Groger63/ChaiseBureau_TO52/architecture.jpg

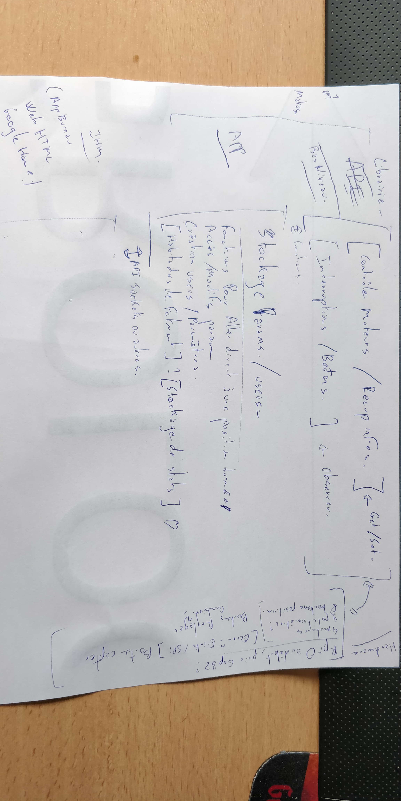
architecture.jpg
