Groger63/ChaiseBureau_TO52/Photos/Existant/IHM_box (2).jpg

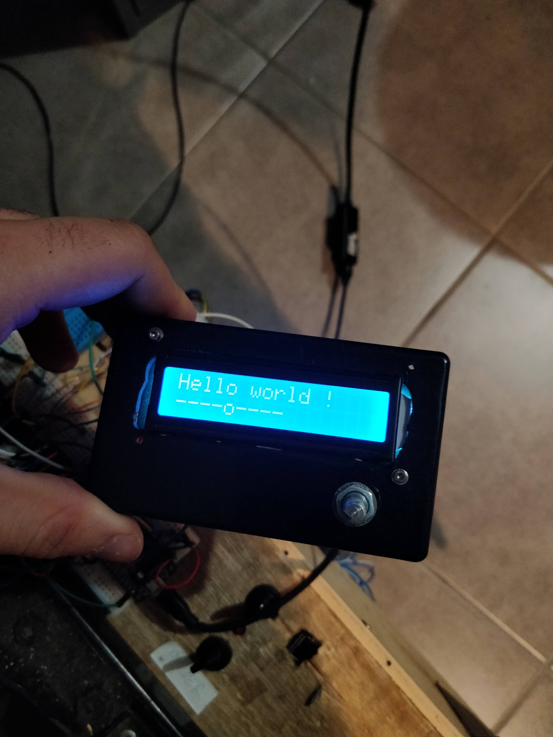
Photos/Existant/IHM_box (2).jpg
