Groger63/ChaiseBureau_TO52/Code/schéma menus.png

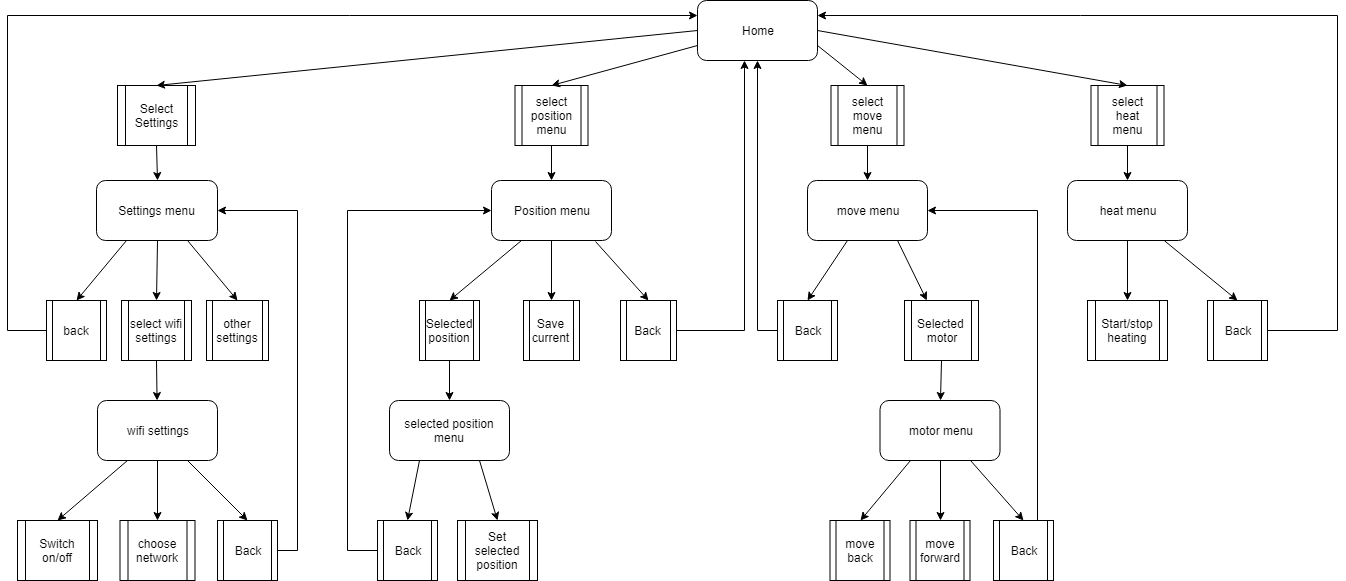
Code/schéma menus.png
