Groger63/ChaiseBureau_TO52/Photos/Existant/2018-10-23 18.43.49.jpg

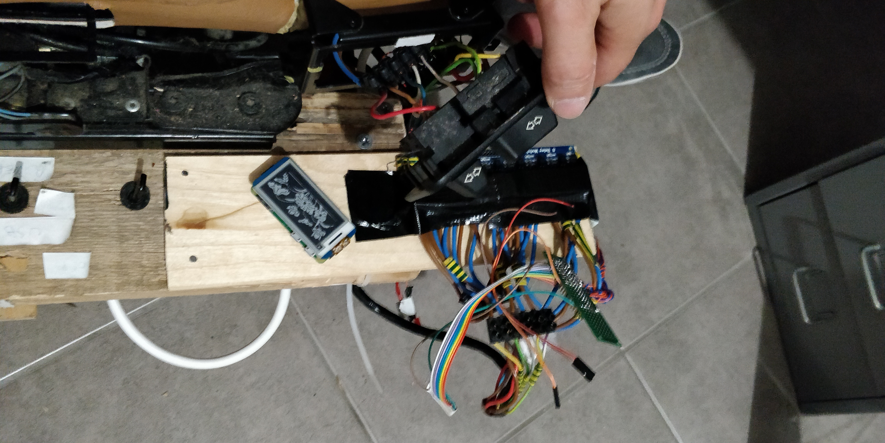
Photos/Existant/2018-10-23 18.43.49.jpg
