Groger63/ChaiseBureau_TO52/Photos/Existant/2018-10-24 00.53.45.jpg

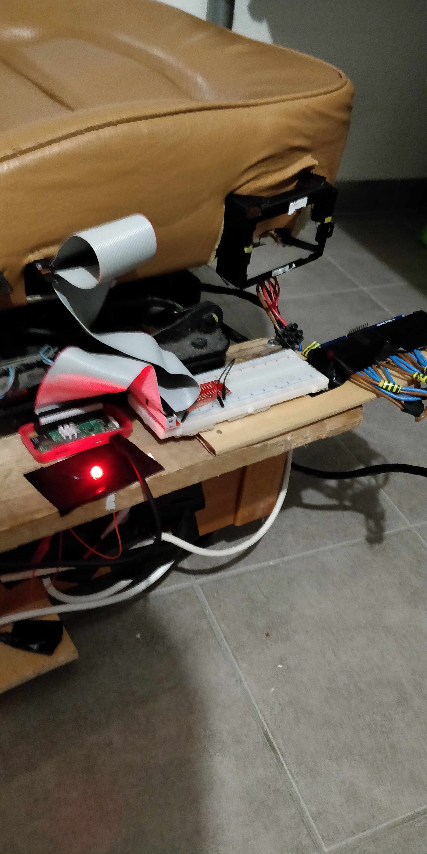
Photos/Existant/2018-10-24 00.53.45.jpg
