Groger63/ChaiseBureau_TO52/Photos/Existant/2018-10-24 11.01.03.jpg

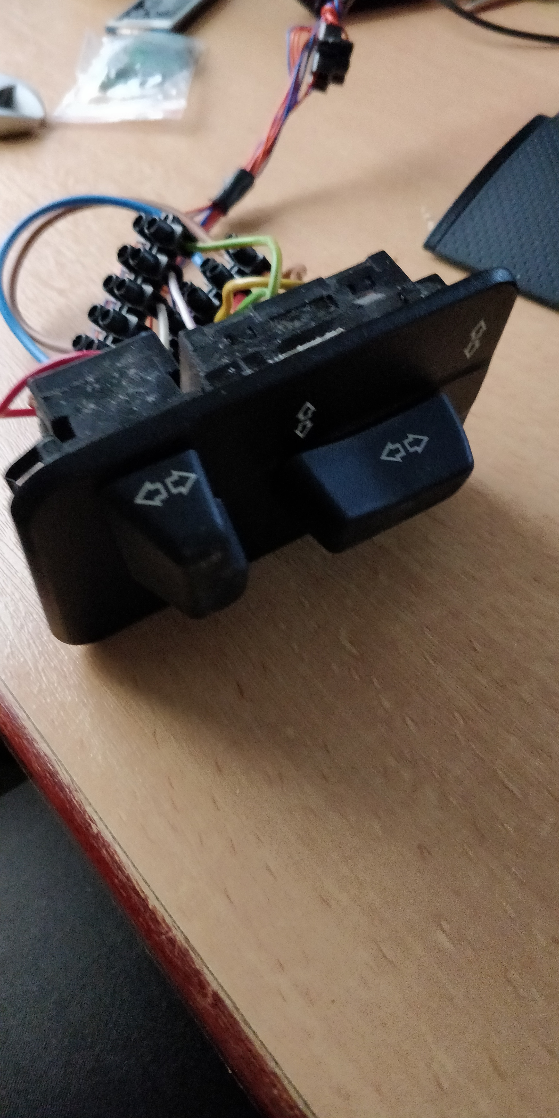
Photos/Existant/2018-10-24 11.01.03.jpg
