Groger63/ChaiseBureau_TO52/Photos/Existant/Arduini_mega.jpg

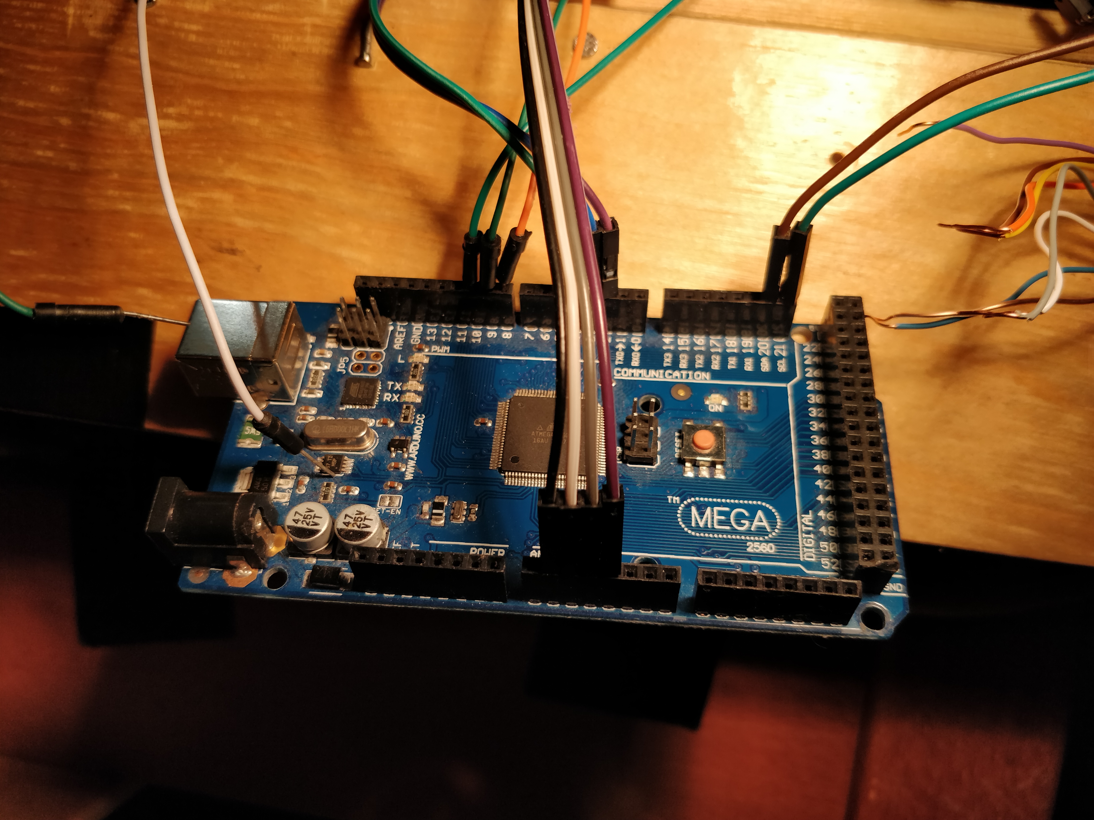
Photos/Existant/Arduini_mega.jpg
