Groger63/ChaiseBureau_TO52/Photos/Existant/Arduino_mega (2).jpg

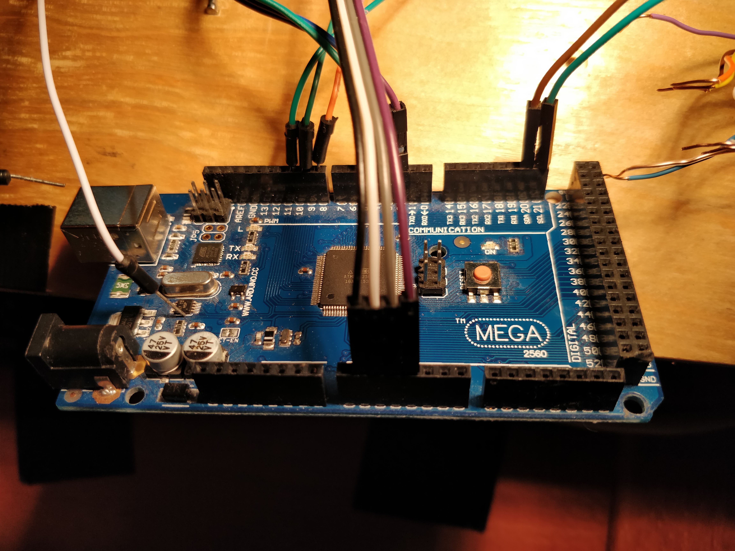
Photos/Existant/Arduino_mega (2).jpg
