Groger63/ChaiseBureau_TO52/Photos/Existant/dossier_adaptator.jpg

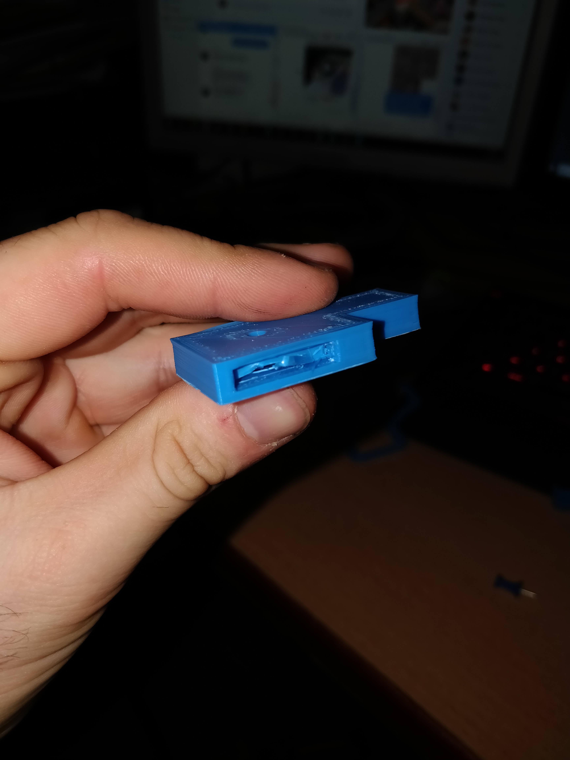
Photos/Existant/dossier_adaptator.jpg
