Groger63/ChaiseBureau_TO52/Photos/Existant/IHM_box.jpg

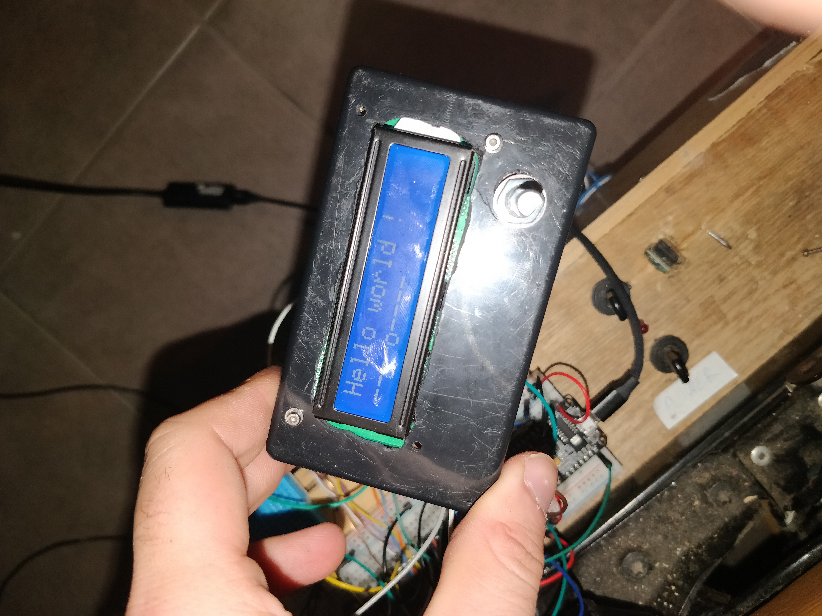
Photos/Existant/IHM_box.jpg
