Groger63/ChaiseBureau_TO52/Photos/Existant/mounted_dossier_adaptator.jpg

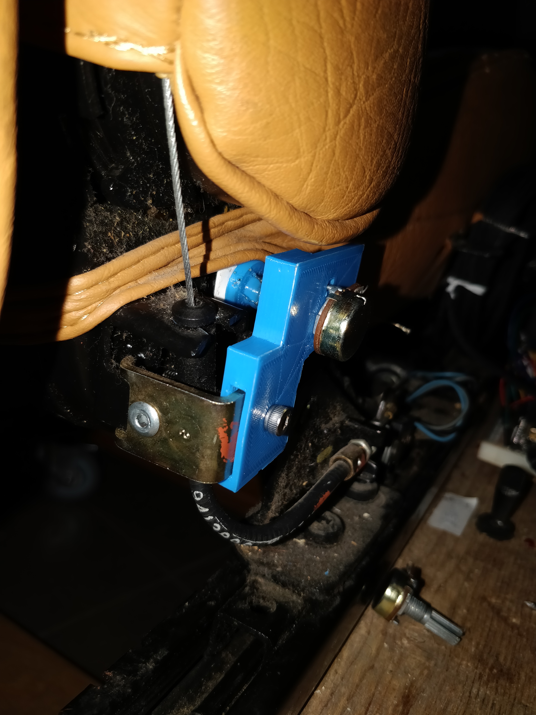
Photos/Existant/mounted_dossier_adaptator.jpg
