Groger63/ChaiseBureau_TO52/Photos/Existant/Ride The Lighning.jpg

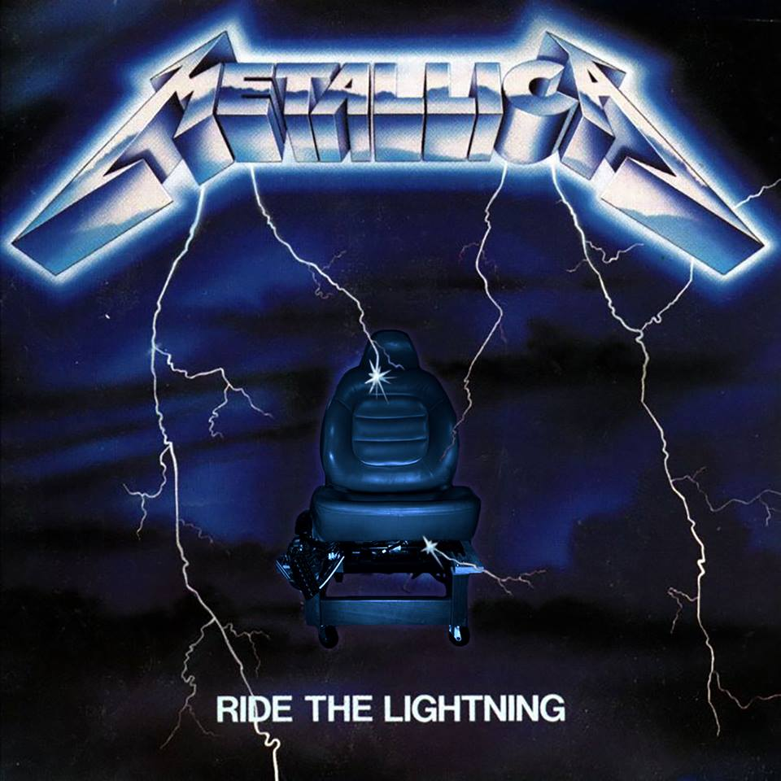
Photos/Existant/Ride The Lighning.jpg
