Groger63/ChaiseBureau_TO52/Photos/Existant/Screen.jpg

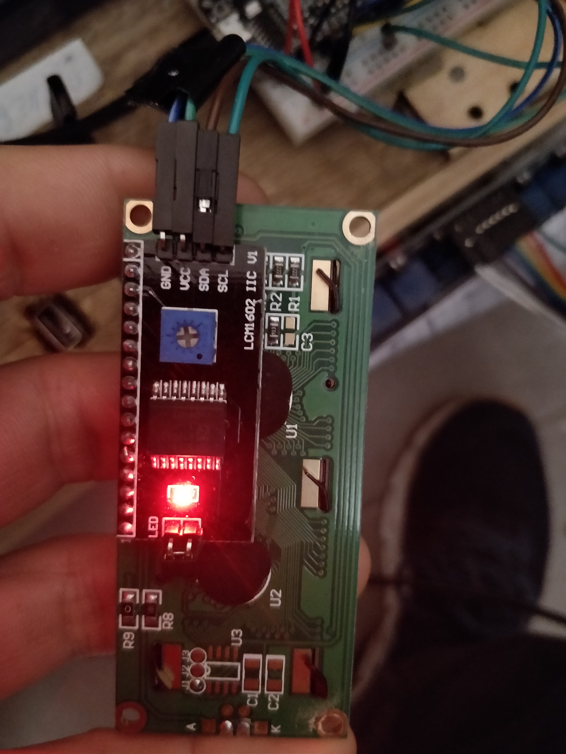
Photos/Existant/Screen.jpg
