Groger63/ChaiseBureau_TO52/Photos/Existant/Seat_front (2).jpg

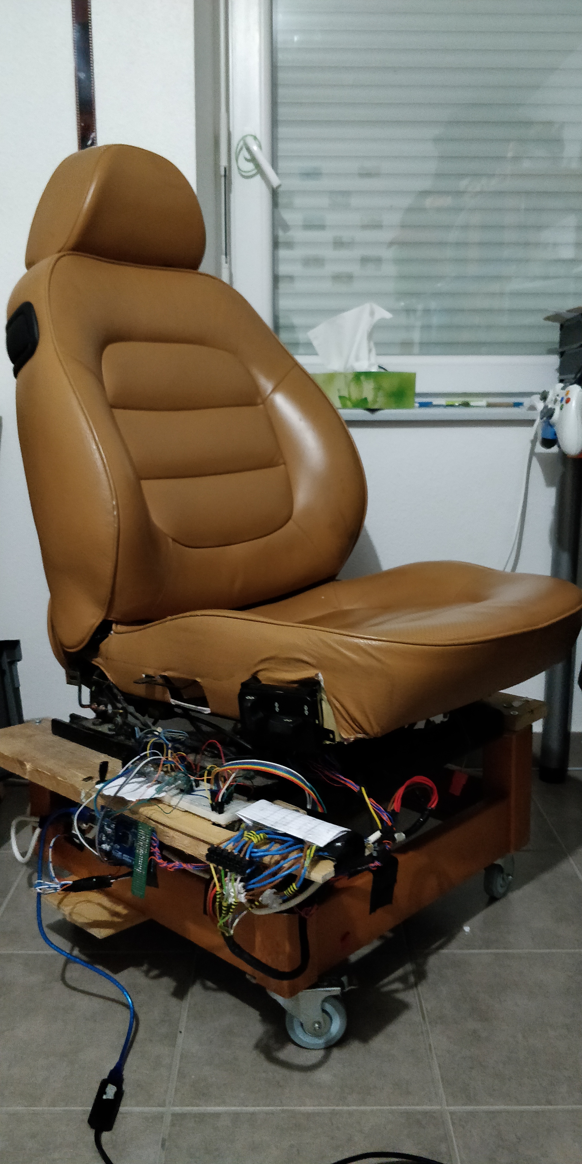
Photos/Existant/Seat_front (2).jpg
