Groger63/ChaiseBureau_TO52/Photos/Existant/Seat_front.jpg

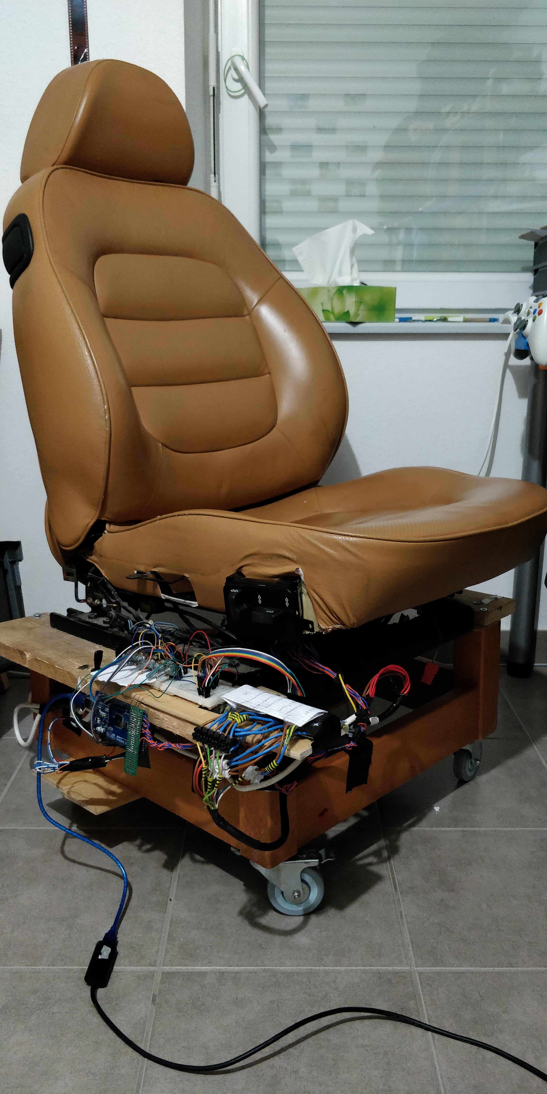
Photos/Existant/Seat_front.jpg
