Groger63/ChaiseBureau_TO52/Photos/Existant/Seat_right.jpg

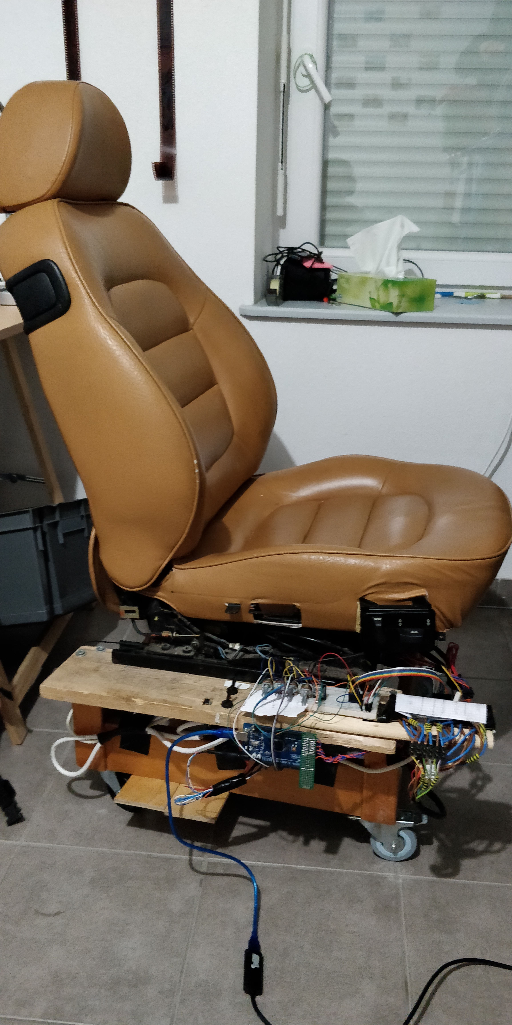
Photos/Existant/Seat_right.jpg
