Groger63/ChaiseBureau_TO52/Photos/Schémas/0001.jpg

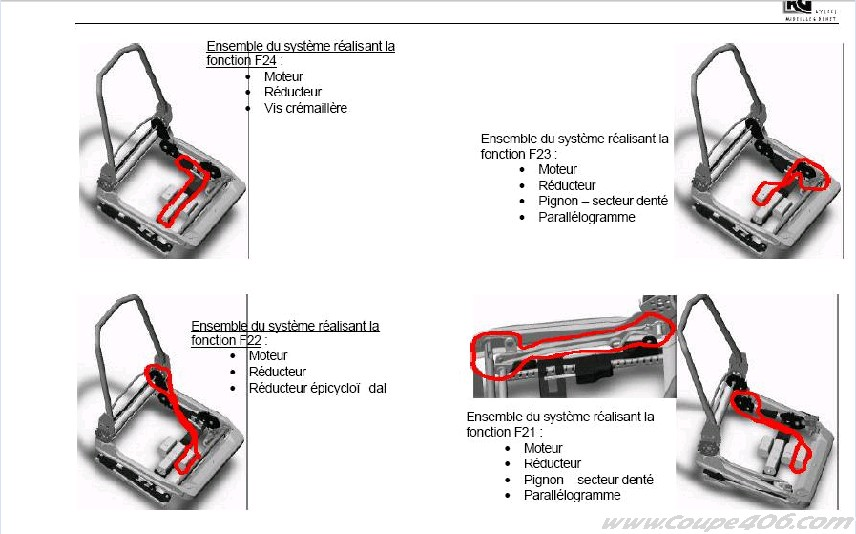
Photos/Schémas/0001.jpg
