Groger63/ChaiseBureau_TO52/Hardware/Nomenclature Boutons.txt

Dossier AV/AR : blanc + bleu
Assive haut/bas : vert&jaune + blanc&violet
Assise AV/AR : vert + gris
Genoux haut/bas : jaune + noir
