Groger63/ChaiseBureau_TO52/Hardware/pièces mécaniques/Assise/potentiometre_assise_1.stl

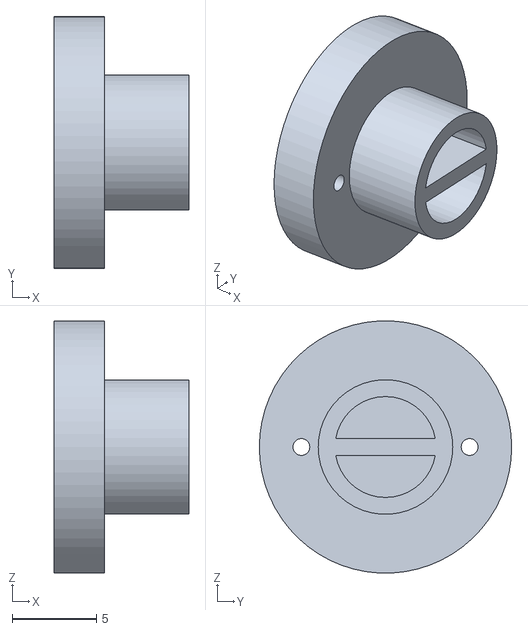
[picture p39: CAD file, 2018-12-28]
Hardware/pièces mécaniques/Assise/potentiometre_assise_1.stl
8.00 x 15.0 x 15.0
