Groger63/ChaiseBureau_TO52/Hardware/pièces mécaniques/Avancement/cremaillere.stl

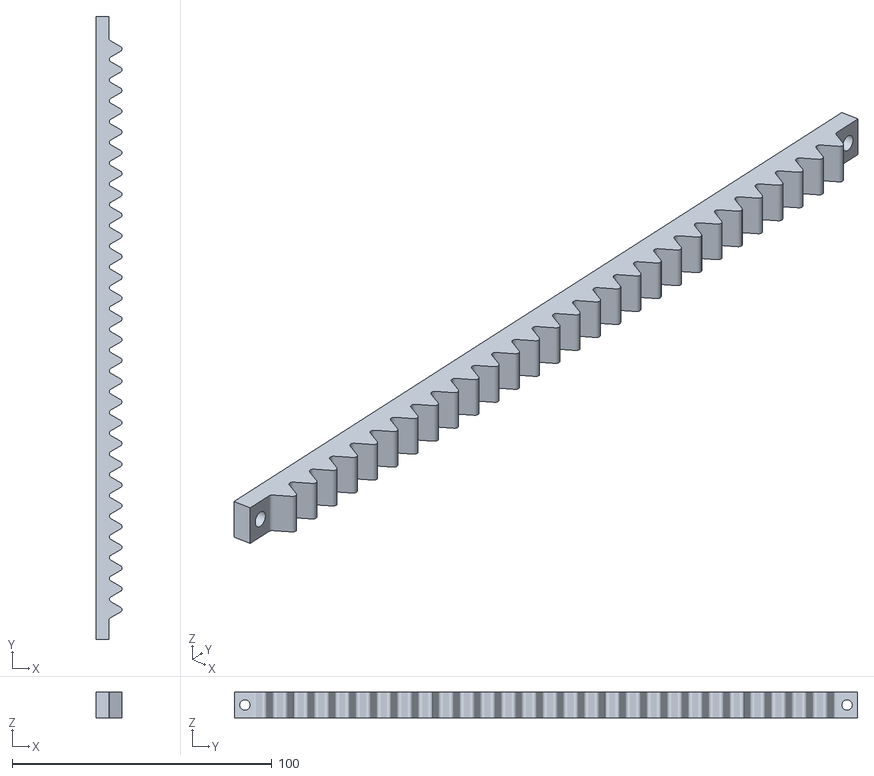
[picture p40: CAD file, 2018-12-28]
Hardware/pièces mécaniques/Avancement/cremaillere.stl
10.1 x 240.0 x 10.0
