Groger63/ChaiseBureau_TO52/Hardware/pièces mécaniques/Hauteur/SupportPotardV2.stl

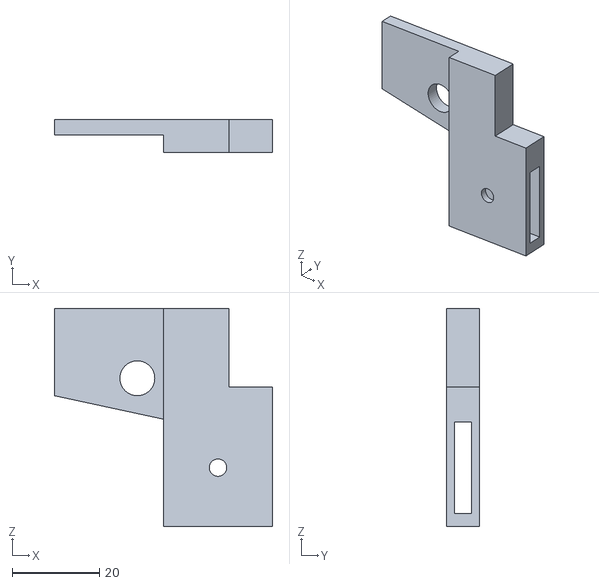
[picture p41: CAD file, 2018-12-28]
Hardware/pièces mécaniques/Hauteur/SupportPotardV2.stl
50.0 x 7.50 x 50.0
