Groger63/ChaiseBureau_TO52/Hardware/pièces mécaniques/Avancement/adaptateur_pot_assise2.stl

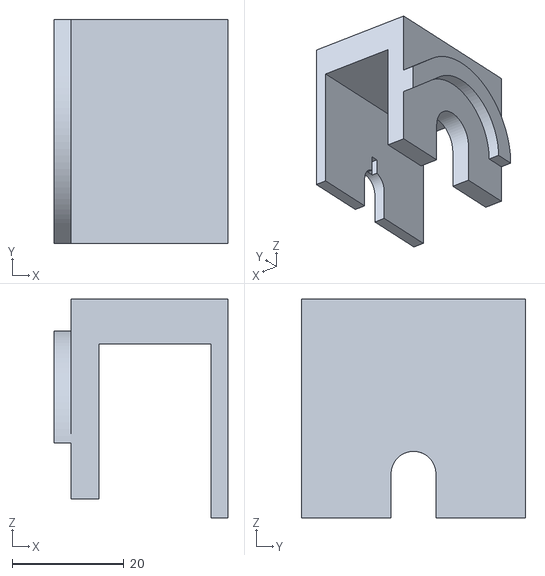
[picture p42: CAD file, 2018-12-28]
Hardware/pièces mécaniques/Avancement/adaptateur_pot_assise2.stl
31.0 x 40.0 x 39.1
