Groger63/ChaiseBureau_TO52/Hardware/pièces mécaniques/Hauteur/potentiometre_assise_1.stl

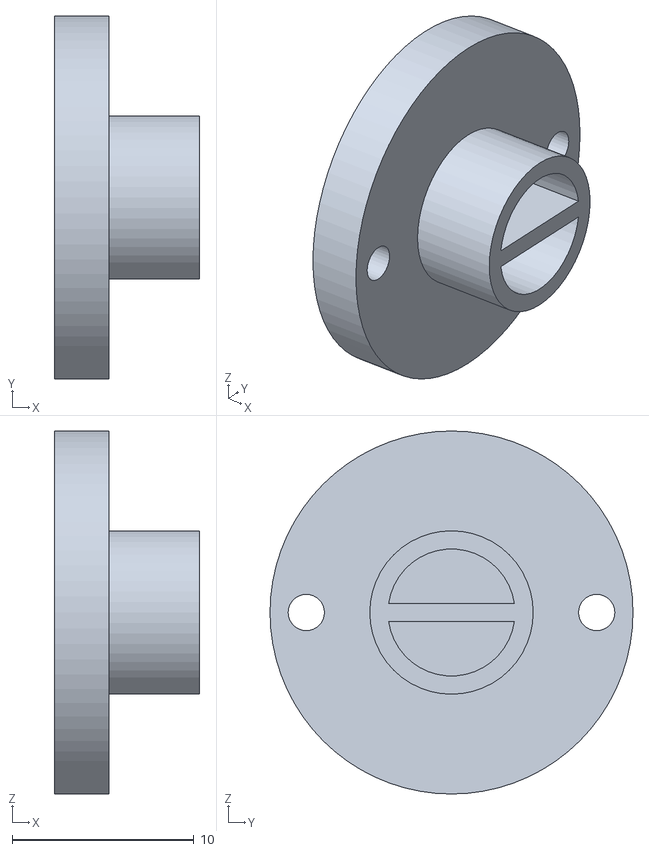
[picture p43: CAD file, 2018-12-28]
Hardware/pièces mécaniques/Hauteur/potentiometre_assise_1.stl
8.00 x 20.0 x 20.0
