Groger63/ChaiseBureau_TO52/Hardware/pièces mécaniques/Avancement/roue.stl

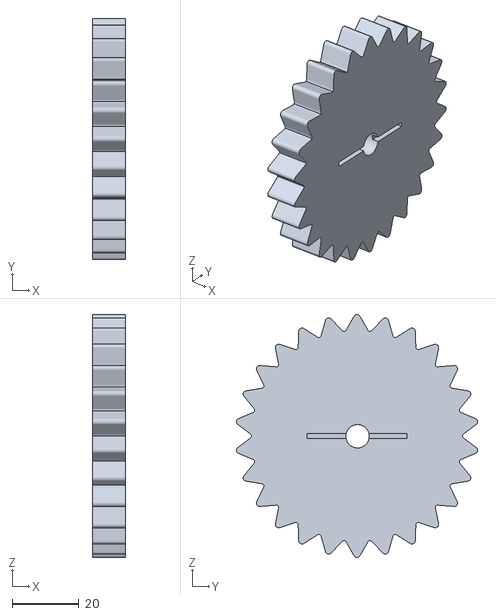
[picture p44: CAD file, 2018-12-28]
Hardware/pièces mécaniques/Avancement/roue.stl
10.0 x 72.2 x 72.7
