Groger63/ChaiseBureau_TO52/Hardware/pièces mécaniques/Hauteur/SupportPotard2.stl

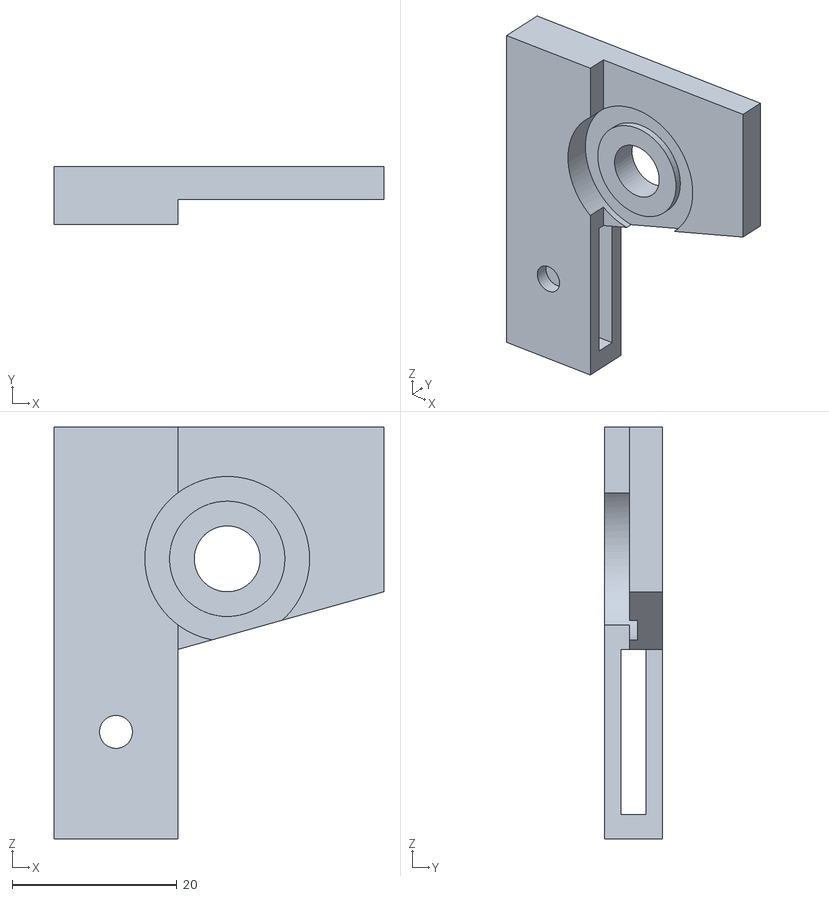
[picture p45: CAD file, 2018-12-28]
Hardware/pièces mécaniques/Hauteur/SupportPotard2.stl
40.0 x 7.00 x 50.0
