Groger63/ChaiseBureau_TO52/(list of files, cad)

Other CAD files:
Hardware/pièces mécaniques/Assise/RoueAssise.CATPart
Hardware/pièces mécaniques/Assise/RoueAssise2.CATPart
Hardware/pièces mécaniques/Avancement/adaptateur_pot_assise2.CATPart
Hardware/pièces mécaniques/Avancement/assemblage avancement.CATProduct
Hardware/pièces mécaniques/Avancement/cremaillere.CATPart
Hardware/pièces mécaniques/Avancement/cremaillere2.CATPart
Hardware/pièces mécaniques/Avancement/potentiometre_assise_1.CATPart
Hardware/pièces mécaniques/Avancement/roue.CATPart
Hardware/pièces mécaniques/Hauteur/Part1.CATPart
Hardware/pièces mécaniques/Hauteur/Product1.CATProduct
Hardware/pièces mécaniques/Hauteur/Produit1.CATProduct
Hardware/pièces mécaniques/Hauteur/SupportPotard.CATPart
Hardware/pièces mécaniques/Hauteur/SupportPotard2.CATPart
Hardware/pièces mécaniques/Hauteur/SupportPotardV2.0.CATPart
Hardware/pièces mécaniques/Hauteur/potentiometre_assise_1.CATPart
Hardware/pièces mécaniques/Hauteur/potentiometre_assise_3.CATPart
Hardware/pièces mécaniques/Product1.CATProduct
Hardware/pièces mécaniques/RouesArnaud/cremaillaire pignon angle helice.CATPart
Hardware/pièces mécaniques/RouesArnaud/pignon angle helice.CATPart
Hardware/pièces mécaniques/User Library-Potentiometer-3.CATPART
Hardware/pièces mécaniques/adaptateur_pot_assise.CATPart
Hardware/pièces mécaniques/assise.CATProduct
Hardware/pièces mécaniques/avancement.CATProduct
Hardware/pièces mécaniques/potentiometre_assise_1.CATPart
