Groger63/ChaiseBureau_TO52/Hardware/PCB design/TO52/Schematics_backup2.brd

## EAGLE design Hardware/PCB design/TO52/Schematics_backup2.brd (2019-01-02)

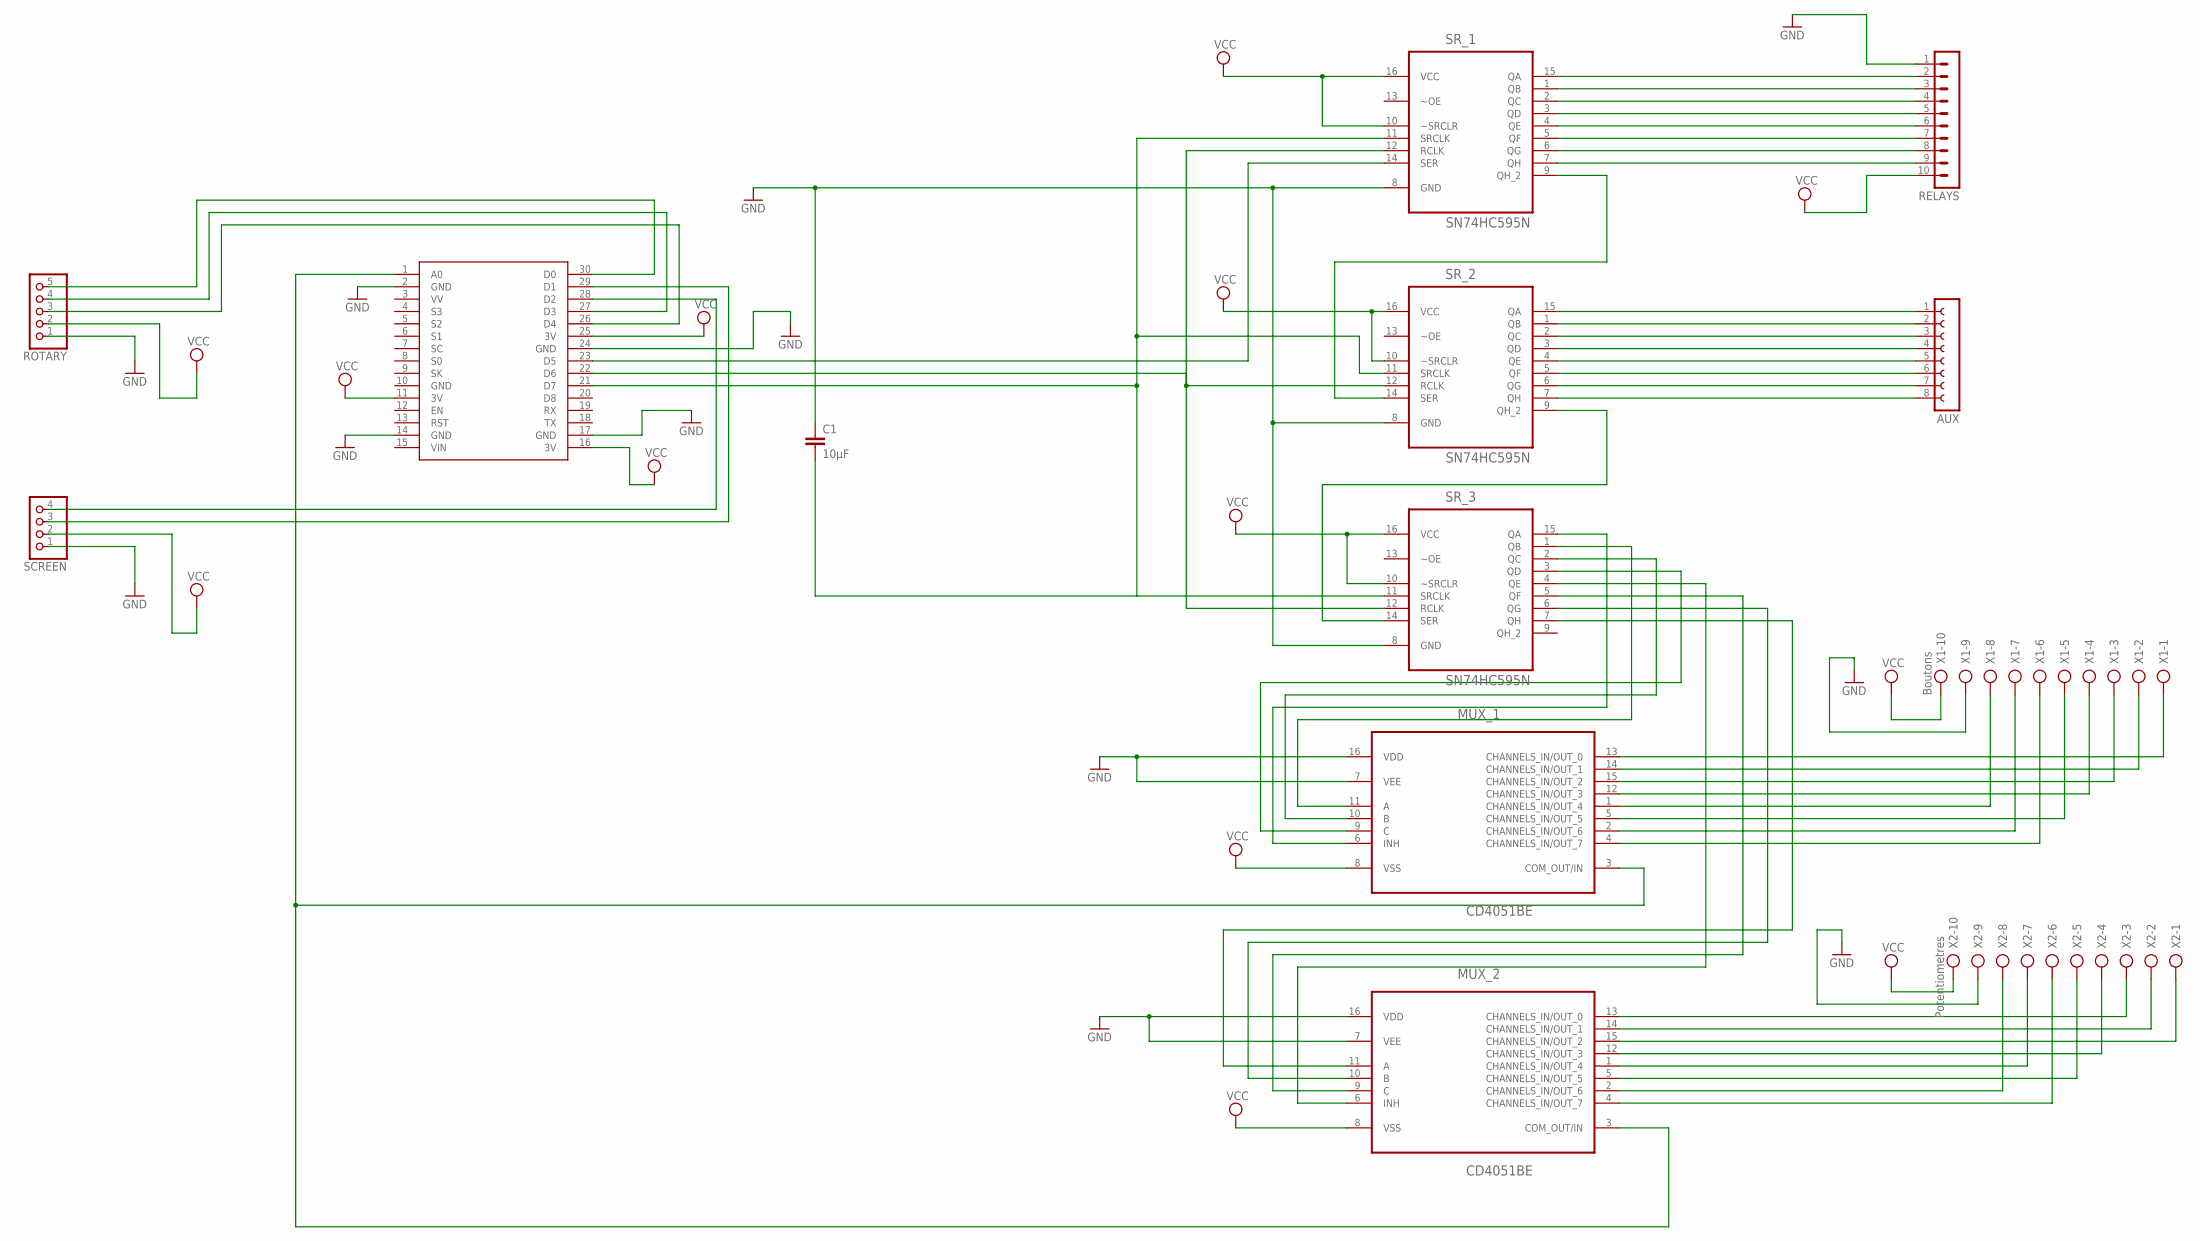
[picture p46: schematic Schematics_backup2.sch]

Parts:
AUX: FE08-1; FE08
C1: 10µF; C2.5-3
MUX_1, MUX_2: CD4051BE; DIP254P762X508-16
RELAYS: MA10-1W
ROTARY: PINHD-1X5; 1X05
SCREEN: PINHD-1X4; 1X04
SR_1, SR_2, SR_3: SN74HC595N; DIP254P762X508-16
U$1: NODEMCU
X1: Boutons; AK300/10
X2: Potentiometres; AK300/10

Connections:
GND: C1.1, MUX_1.7 (VEE), MUX_1.16 (VDD), MUX_2.7 (VEE), MUX_2.16 (VDD), RELAYS.1, ROTARY.1, SCREEN.1, SR_1.8 (GND), SR_2.8 (GND), SR_3.8 (GND), U$1.2 (GND), U$1.10 (GND), U$1.14 (GND), U$1.17 (GND), U$1.24 (GND), X1.9, X2.9
unnamed: RELAYS.2, SR_1.15 (QA)
unnamed: SR_1.14 (SER), U$1.23 (D5)
unnamed: SR_1.12 (RCLK), SR_2.12 (RCLK), SR_3.12 (RCLK), U$1.22 (D6)
unnamed: SR_2.9 (QH_2), SR_3.14 (SER)
unnamed: C1.2, SR_1.11 (SRCLK), SR_2.11 (SRCLK), SR_3.11 (SRCLK), U$1.21 (D7)
unnamed: RELAYS.3, SR_1.1 (QB)
unnamed: RELAYS.4, SR_1.2 (QC)
unnamed: RELAYS.5, SR_1.3 (QD)
unnamed: RELAYS.6, SR_1.4 (QE)
unnamed: RELAYS.7, SR_1.5 (QF)
unnamed: RELAYS.8, SR_1.6 (QG)
unnamed: RELAYS.9, SR_1.7 (QH)
unnamed: MUX_1.13 (CHANNELS_IN/OUT_0), X1.1
unnamed: MUX_1.14 (CHANNELS_IN/OUT_1), X1.2
unnamed: SR_1.9 (QH_2), SR_2.14 (SER)
unnamed: MUX_1.15 (CHANNELS_IN/OUT_2), X1.3
unnamed: MUX_1.12 (CHANNELS_IN/OUT_3), X1.4
unnamed: MUX_1.1 (CHANNELS_IN/OUT_4), X1.8
unnamed: MUX_1.5 (CHANNELS_IN/OUT_5), X1.5
unnamed: MUX_1.2 (CHANNELS_IN/OUT_6), X1.7
unnamed: MUX_1.4 (CHANNELS_IN/OUT_7), X1.6
unnamed: MUX_2.1 (CHANNELS_IN/OUT_4), X2.7
unnamed: MUX_2.2 (CHANNELS_IN/OUT_6), X2.8
unnamed: MUX_1.6 (INH), SR_3.15 (QA)
unnamed: MUX_1.11 (A), SR_3.1 (QB)
unnamed: MUX_1.10 (B), SR_3.2 (QC)
unnamed: MUX_1.9 (C), SR_3.3 (QD)
unnamed: MUX_2.6 (INH), SR_3.4 (QE)
unnamed: MUX_2.9 (C), SR_3.5 (QF)
unnamed: MUX_2.10 (B), SR_3.6 (QG)
unnamed: MUX_2.11 (A), SR_3.7 (QH)
unnamed: MUX_1.3 (COM_OUT/IN), MUX_2.3 (COM_OUT/IN), U$1.1 (A0)
unnamed: MUX_2.4 (CHANNELS_IN/OUT_7), X2.6
unnamed: MUX_2.5 (CHANNELS_IN/OUT_5), X2.5
unnamed: MUX_2.12 (CHANNELS_IN/OUT_3), X2.4
unnamed: MUX_2.15 (CHANNELS_IN/OUT_2), X2.1
unnamed: MUX_2.14 (CHANNELS_IN/OUT_1), X2.2
unnamed: MUX_2.13 (CHANNELS_IN/OUT_0), X2.3
unnamed: AUX.1, SR_2.15 (QA)
unnamed: AUX.2, SR_2.1 (QB)
unnamed: AUX.3, SR_2.2 (QC)
unnamed: AUX.4, SR_2.3 (QD)
unnamed: AUX.5, SR_2.4 (QE)
unnamed: AUX.6, SR_2.5 (QF)
unnamed: AUX.7, SR_2.6 (QG)
unnamed: AUX.8, SR_2.7 (QH)
unnamed: ROTARY.3, U$1.26 (D4)
unnamed: ROTARY.5, U$1.30 (D0)
unnamed: ROTARY.4, U$1.27 (D3)
unnamed: SCREEN.4, U$1.28 (D2)
unnamed: SCREEN.3, U$1.29 (D1)
VCC: MUX_1.8 (VSS), MUX_2.8 (VSS), RELAYS.10, ROTARY.2, SCREEN.2, SR_1.10 (~SRCLR), SR_1.16 (VCC), SR_2.10 (~SRCLR), SR_2.16 (VCC), SR_3.10 (~SRCLR), SR_3.16 (VCC), U$1.11 (3V), U$1.16 (3V), U$1.25 (3V), X1.10, X2.10

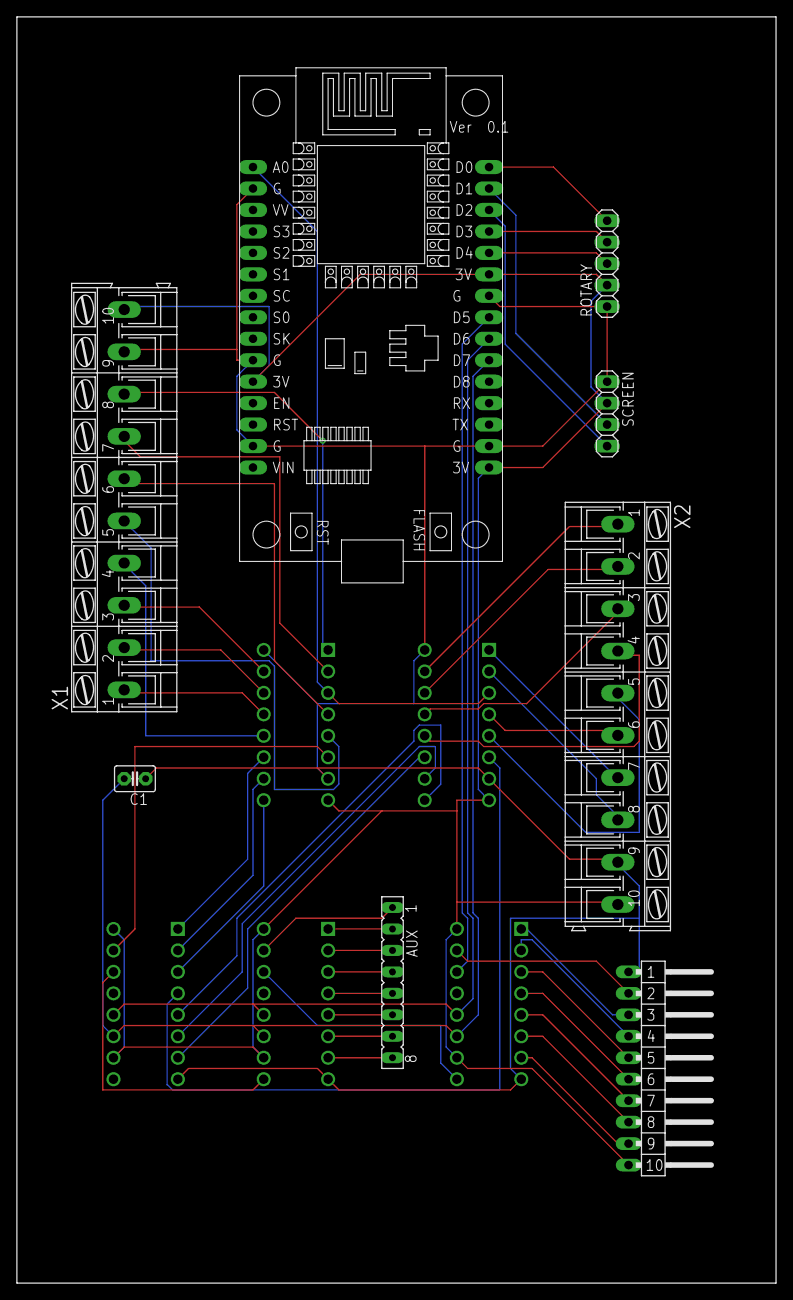
[picture p47: board Schematics_backup2.brd from above]

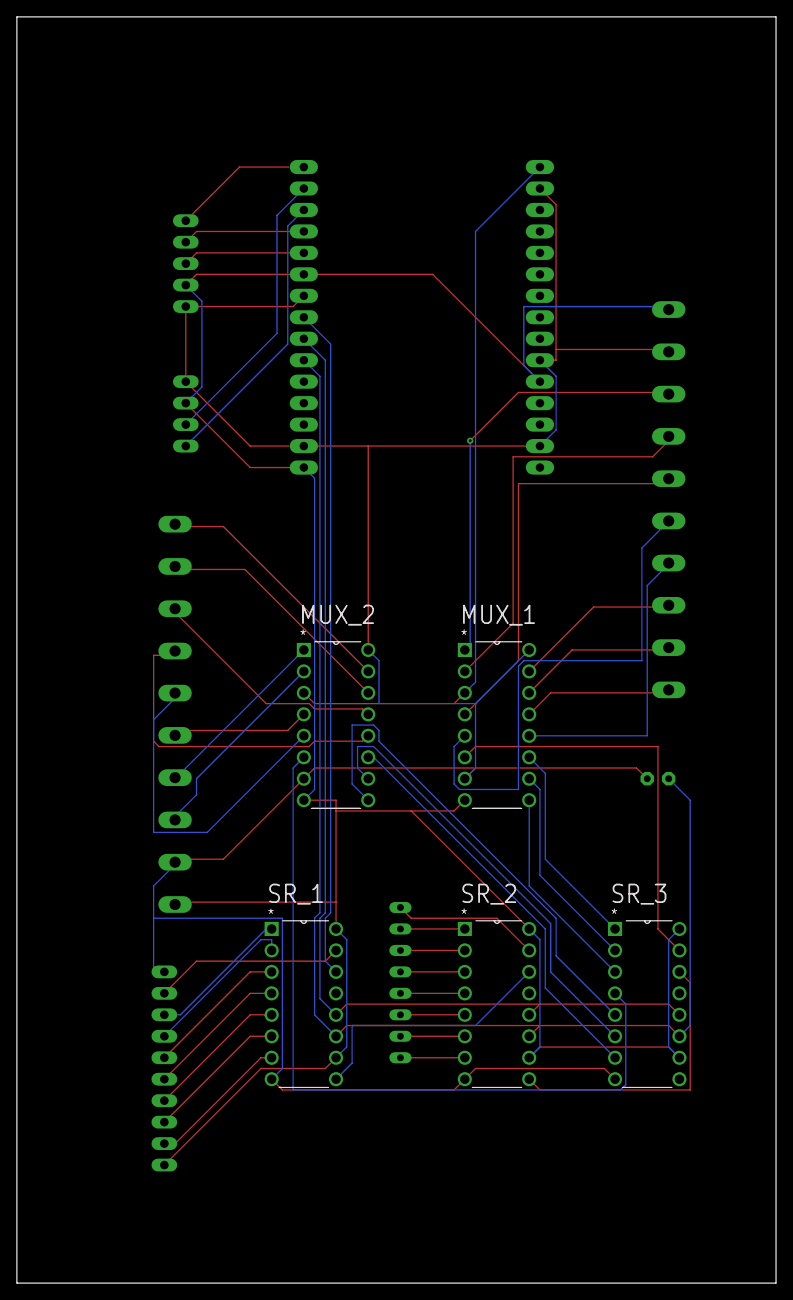
[picture p48: board Schematics_backup2.brd from below]

Board: 2 copper layers, 89.8 x 149.8 mm, 13 parts (5 on the bottom side), 53 nets.
