Groger63/ChaiseBureau_TO52/(commit log)

2018-10-16 Mise à jour du cahier des charges
2018-10-16 Ajout de trucs
2018-10-16 Ajout du fichier doc pour les axes de travail
2018-10-23 2e partie de la réflexion
2018-11-08 Avancé pas mal la partie Arduino Contrôle des moteurs avec le shiftreg Préparé le terrain pour d'autres trucs La classe Arduino String possède des soucis avec la librairie freertos...
2018-12-28 Long commit : MAJ du code de nodeMCU Ajout des design du PCB et schéma électrique Ajout des pièces CATIA pour les adaptateurs des capteurs
    [Product1.CATProduct, Produit1.CATProduct, RoueAssise.CATPart, RoueAssise2.CATPart, Schematics.brd, Schematics.sch, Schematics_backup.brd, Schematics_backup.sch]
2018-12-28 Ajout de la connexion wifi
2018-12-30 ajout de fonctions de connexion wifi
2018-12-30 MAJ des librairies moteurs pour avoir une position en %
2019-01-02 Nettoyage de l'arborescence
2019-01-02 Avancement du rapport
    [Part1.CATPart, Product1.CATProduct, Schematics_backup2.brd, cremaillaire pignon angle helice.CATPart, pignon angle helice.CATPart]
2019-01-04 MAJ rapport & ajout schéma electrique siege de base
    [schema_siege.sch]
2019-01-11 Update général de code wifi
2019-01-14 Implémentation des menus wifi fonctionnelle
2019-01-14 Ajout de JEAN-SIEGEUI !
